valerionew/unisolder-notes/BOMs/Unisolder BOM Digikey.xlsx

REF. | Component | Digikey PN | BOM QTY | Digikey Price Per Unit | Total Price
D18, D19 | MMBD1505A | ‎MMBD1505ACT-ND‎ (https://www.digikey.com/product-detail/en/MMBD1505A/MMBD1505ACT-ND/965669/?itemSeq=286846302) | 2 | 0.34 | $0.68
Rs1 | VISHAY WSL36373L000FEA 0.003 ohm shunt | ‎WSLI-.003CT-ND‎ (https://www.digikey.com/product-detail/en/WSL36373L000FEA/WSLI-.003CT-ND/713514/?itemSeq=286846315) | 1 | 1.7 | $1.70
SPK1 | PB1221P | AI-1441-TWT-12V-R | 1 | 2.36 | $2.36
U6 | REF3030 | 296-26323-1-ND (https://www.digikey.com/product-detail/en/texas-instruments/REF3030AIDBZR/296-26323-1-ND/2254966) | 1 | 1.48 | $1.48
U16 | ADG734 | ADG734BRUZ-ND | 1 | 4.01 | $4.01
U15 | MCP4561T-104E/MS | MCP4561T-104E/MSCT-ND | 1 | 0.99 | $0.99
U10 | MCP4651-104E/ST | MCP4651-104E/ST-ND | 1 | 0.96 | $0.96
 | JBC T245 |  | 1 | 0 | $0.00
 | Tip JBC C245-906 |  | 1 | 0 | $0.00
 | Toroidal transformer 24V 120VA |  | 1 | 0 | $0.00
IronConn | Iron Connector | RPC1-12RB-6P(71) | 1 | 2.98 | $2.98
C1, C3, C5, C7, C9, C10, C17, C18, C59, C60, C62, C65 | SAMSUNG CL21B103KCANNNC 10nF 100V | ‎1276-1249-1-ND‎ (https://www.digikey.com/product-detail/en/CL21B103KCANNNC/1276-1249-1-ND/3889335/?itemSeq=286846531) | 12 | 0.052 | $0.62
C2, C6, C12, C16, C20, C21, C67, C70, C73, C74, C77 | SAMSUNG CL21B104KCFSFNG 100n 100V | 1276-6733-1-ND | 11 | 0.129 | $1.42
C4 | NICHICON UPW1C471MPD 470uF 16V | 493-11717-1-ND | 1 | 0.47 | $0.47
C8, C11 | NICHICON UVZ1H221MPD 220uF 50V | 493-13467-1-ND | 2 | 0.48 | $0.96
C13 | NICHICON UVZ1H220MDD 22uF 50V | 493-1338-ND | 1 | 0.24 | $0.24
C14, C15, C19 | SAMSUNG CL31A106KAHNNNE 10u 25V | 1276-1075-1-ND | 3 | 0.185 | $0.55
C22 | NICHICON UVZ2A470MPD 47uF 100V | 493-13508-1-ND | 1 | 0.47 | $0.47
C23, C47 | VISHAY 293D227X9010D2TE3 220uf 10V | 718-1072-1-ND | 2 | 1.11 | $2.22
C24, C25, C26, C27, C28, C29, C30, C31, C32, C33, C34, C35, C38, C39, C41, C42, C43, C44, C45, C46, C48, C49, C50, C51, C52, C53, C54, C58 | SAMSUNG CL10B104JB8NNNC 100n | 1276-1033-1-ND | 28 | 0.053 | $1.48
C36, C37, C40, C57, C68, C69, C75 | SAMSUNG CL21A106KOQNNNF 10u 16V | 1276-6455-1-ND | 7 | 0.118 | $0.83
C55, C56 | KEMET C0603C150J5GACTU 15p | 720-1618-1-ND | 2 | 0.088 | $0.18
C61, C63, C64, C66 | SAMSUNG CL21B102KBANNNC 1n | 1276-2425-1-ND | 4 | 0.042 | $0.17
C71 | MURATA GRM21BR61E106KA73L 10u 25V | 1276-2890-1-ND | 1 | 0.28 | $0.28
C76 | SAMSUNG CL21C101JBANNNC 100p | 732-7852-1-ND | 1 | 0.1 | $0.10
D16, D20, D21 | BAV199 | BAV199Q-7-FDICT-ND | 3 | 0.24 | $0.72
 | MOLEX 039013022 555702R1 | WM1021-ND | 10 | 0.32 | $3.20
FUSE1 | Keystone 3518P fuse holder | 36-3518P-ND | 2 | 0.27 | $0.54
 | MOLEX 39-00-0039 | WM2501-ND | 20 | 0.17 | $3.40
 | MOLEX 039013022 555702R1 | WM1021-ND | 10 | 0.303 | $3.03
 | MOLEX 039288020 5566-02A-210 | WM23800-ND | 2 | 0.67 | $1.34
 | MOLEX 039288040 5566-04A-210 | WM23801-ND | 3 | 1.05 | $3.15
 | 3M 89110-0101HA | 3M155961-ND | 5 | 1.02 | $5.10
 | 3M N2510-6002RB | MHC10K-ND | 5 | 1.84 | $9.20
HOLDER | RJ11 6 pin HOLDER | WM6356-ND | 1 | 1.13 | $1.13
 | MOLEX 022013037 2695-03RP | WM2001-ND | 10 | 0.19 | $1.90
 | MOLEX 008550102 2759-(555)L | WM2312-ND | 10 | 0.266 | $2.66
 | MOLEX 022292031 AE-6410-03A(241) | WM2745-ND | 2 | 0.67 | $1.34
 | CONN RECEPT 4POS DUAL | WM3701-ND | 3 | 0.31
Ja, Jb, Jc, Jd, Je, Jg | Vishay 0402 0ohm | 541-0.0JCT-ND | 10 | 0.034 | $0.34
L1 | FERROCORE DE1209-330 330uH | 732-4026-1-ND | 1 | 2.12 | $2.12
L2 | FERROCORE DE0704-330 330uH | 732-4046-1-ND | 1 | 2.25 | $2.25
L3 | FERROCORE DJNR4018-100-S 10uH | 732-10757-1-ND | 1 | 0.6 | $0.60
OLED (get a cheaper one please, i had to get this for invoicing reasons) | DD-12864WE-4A | 938 | 1 | 19.95 | $19.95
 | Header 5 | S6103-ND | 1 | 0.47 | $0.47
Q3, Q9 | MMBT5401 | MMBT5401LT1GOSCT-ND | 2 | 0.22 | $0.44
Q4, Q5, Q12 | MMBT5551 | MMBT5551LT1GOSCT-ND | 3 | 0.21 | $0.63
Q6, Q13 | BC847C | 1727-2924-1-ND | 2 | 0.14 | $0.28
Q7 | BCX56-16 | 1727-2930-1-ND | 1 | 0.39 | $0.39
Q14, Q15, Q16, Q18, Q19, Q21, Q22 | IRLML6401 | SI2315BDS-T1-E3CT-ND | 7 | 0.427 | $2.99
R1 | 10k | 541-3983-1-ND | 2 | 0.1 | $0.20
R2, R7, R15, R19, R21, R22 | 4.7k | 541-4207-1-ND | 6 | 0.056 | $0.34
R3 | 0 | SOLDER | 1 | 0 | $0.00
R4, R30, R35, R37, R42, R52, R54, R55, R56, R57, R59, R62, R65 | 1.5k 0.1% | P1.5KDACT-ND (https://www.digikey.com/product-detail/en/panasonic-electronic-components/ERA-6AEB152V/P1.5KDACT-ND/1465951) | 13 | 0.302 | $3.93
R5, R11, R12, R13, R16, R17, R36, R40, R41, R45, R46, R58, R68, R69 | 3k | 311-3.0KARCT-ND | 14 | 0.037 | $0.52
R68 | 3k | A126368CT-ND | 1 | 0.052 | $0.05
 | 4.7k | 311-4.70KCRCT-ND | 1 | 0.052 | $0.05
R6, R9, R14 | 150 | RHM150BUCT-ND | 3 | 0.15 | $0.45
R8, R18 | 30k | RMCF0805JT30K0CT-ND | 2 | 0.1 | $0.20
R10 | 10k | USE R1 | 1 | 0 | $0.00
R20, R32 | 330 | 541-4168-1-ND | 2 | 0.1 | $0.20
R23, R27, R28, R33, R44 | 1.8k | 541-1.8KACT-ND (https://www.digikey.com/product-detail/en/vishay-dale/CRCW08051K80JNEA/541-1.8KACT-ND/1180346) | 5 | 0.044 | $0.22
R24, R34, R51, R60 | 1k 0.1% | 541-3977-1-ND | 4 | 0.06 | $0.24
R25, R26 | 27 | 541-27ACT-ND (https://www.digikey.com/product-detail/en/vishay-dale/CRCW080527R0JNEA/541-27ACT-ND/1180302) | 2 | 0.1 | $0.20
R29, Ra, Rb, Rc, Rd, Re, Rf, Rg | 47 | RMCF0805JT47R0CT-ND | 6 | 0.02 | $0.12
R31, R39 | 100 0.1% | RNCF0805BTE100RCT-ND | 2 | 0.42 | $0.84
R38, R48 | 47k 0.1% | P47KDACT-ND | 2 | 0.36 | $0.72
R43, R61, R64 | 15k | RMCF0805JT15K0CT-ND | 3 | 0.02 | $0.06
R47, R49, R50, R66 | 27k 0.1% | P27KDACT-ND | 5 | 0.32 | $1.60
R53, R63 | 10k 0.1% | P10KDACT-ND | 2 | 0.36 | $0.72
R67 | 820k | RMCF0805JT820KCT-ND | 1 | 0.02 | $0.02
Rc2 | 2k 3364X | 490-2649-1-ND | 1 | 1.57 | $1.57
Rgnd1 | 10M 10000k 2512 | 541-10MXCT-ND | 1 | 0.39 | $0.39
S1, S2, S3 | 4.5 x 6.5 SWITCH-TACTILE SCHURTER 1301.9303 | 486-1943-ND | 3 | 0.23 | $0.69
TVS1 | 1.5KE56A | 1.5KE56A-E3/54GICT-ND | 1 | 0.66 | $0.66
U1 | LM2675M-3.3 | LM2675M-3.3/NOPB-ND‎ | 1 | 5.09 | $5.09
U2 | TC4428ACOA | TC4428ACOA-ND | 1 | 1.17 | $1.17
U3 | SN74HC02D | 296-1188-1-ND | 1 | 0.478 | $0.48
U4 | TC1047AVNBTR | TC1047AVNBCT-ND | 1 | 0.64 | $0.64
U5 | PIC32MX564F128H-I/PT | PIC32MX564F128H-I/PT-ND | 1 | 4.73 | $4.73
U7 | ADuM3160 | ADUM3160BRWZ-RLCT-ND | 1 | 7.77 | $7.77
U8 | 24LC64-I/SN | 24LC64-I/SN-ND | 1 | 0.39 | $0.39
U11 | MCP4716A0T-E/CH | MCP4716A0T-E/CHCT-ND | 1 | 0.84 | $0.84
U12, U13, U18 | MCP6V27-E/SN | MCP6V27-E/SN-ND | 3 | 2.41 | $7.23
USB1 | USB 5 pin | WM2072-ND‎ (https://www.digikey.com/product-detail/en/5000751517/WM2072-ND/1643336/?itemSeq=286905705) | 1 | 4.55 | $4.55
Y1 | 8Mhz HC49US quartz | 300-6017-ND | 1 | 0.59 | $0.59
ZD1, ZD2, ZD4 | BZX384-B3V0.115 3V zener diode | 1727-3653-1-ND | 3 | 0.33 | $0.99
ZD3 | 36V zener diode | MMSZ5258B-FDICT-ND | 1 | 0.24 | $0.24
FUSE1 | ZKS-5A fuse | 283-2686-ND | 1 | 0.34 | $0.34
ZD5, ZD6, ZD7 | 15V zener diode | 1727-3640-1-ND | 3 | 0.33 | $0.99
U1 (alternative to line 80) | LM2675M-ADJ |  | 0 | 0 | $0.00
U19 (see unisolder-notes) | FAN5331 | FAN5331SXCT-ND | 1 | 0.99 | $0.99
U14 | LM4041AIM3-1.2 | LM4041AIM3-1.2/NOPBCT-ND | 1 | 1.93 | $1.93
Q2, Q8 | AOD409 | 785-1103-1-ND | 3 | 0.97 | $2.91
Q1 | NZT605 | NZT605CT-ND | 1 | 0.43 | $0.43
Q10, Q11 | IPD053N08 | ‎IPD053N08N3GATMA1CT-ND‎ | 2 | 2.5 | $2.50
D6, D7, D12 | SK310SMA | SK310A-TPCT-ND | 3 | 0.58 | $1.74
D22 | SK34SMA | SS34FACT-ND | 1 | 0.45 | $0.45
D9, D11, D13 | GF1M | GF1MFSCT-ND | 3 | 0.49 | $1.47
D5, D8, D10, D14, D15 | BAT46W | ‎1727-4816-1-ND‎ (https://www.digikey.com/product-detail/en/BAT46WH%2C115/1727-4816-1-ND/2531303/?itemSeq=286916334) | 5 | 0.35 | $1.75
D1, D2, D3, D4 | SB5100 | SB5100FSCT-ND | 4 | 0.83 | $3.32
U6 (possible alternative to | RED3030 | 296-26323-1-ND | 1 | 1.43 | $1.43
U17 | MCP6V03-E/SN | MCP6V03-E/SN-ND | 1 | 1.79 | $1.79
 | 150 0.1% | 150ADCT-ND | 1 | 0.66 | $0.66
 | 5.6k 0.1% | 5.6KADCT-ND | 1 | 0.66 | $0.66
 | 10 0.1% | A105944CT-ND | 1 | 0.62 | $0.62
 | TOTAL
 |  |  |  |  | $164.99
