valerionew/unisolder-notes/BOMs/UniSolder52_BOM_original_25Mar2019_Download.xls

Designator | Comment | Supplier | Quantity | Package | Description
C1, C3, C5, C7, C9, C10, C17, C18, C59, C60, C62, C65 | 10n 100V | Comet | 12 | 0805 | Capacitor
C2, C6, C12, C16, C20, C21, C67, C70, C73, C74, C77 | 100n 100V | Comet | 11 | 0805 | Capacitor, Capacitor, Capacitor, Capacitor, Capacitor, Capacitor, Capacitor (Semiconductor SIM Model), Capacitor, Capacitor, Capacitor, Capacitor
C4 | 470uF 16V | Comet | 1 | TH10x12.5 | Polarized Capacitor (Radial)
C8, C11 | 220uF 50V | Comet | 2 | TH10x12.5 | Polarized Capacitor (Radial)
C13 | 22uF 50V | Comet | 1 | TH5x11 | Polarized Capacitor (Radial)
C14, C15, C19 | 10u 25V | Comet | 3 | 1206 | Capacitor
C22 | 47uF 100V | Comet | 1 | TH10x12.5 | Polarized Capacitor (Radial)
C23, C47 | 220uf 10V | Comet | 2 | D | Tantalum SMD Capacitor
C24, C25, C26, C27, C28, C29, C30, C31, C32, C33, C34, C35, C38, C39, C41, C42, C43, C44, C45, C46, C48, C49, C50, C51, C52, C53, C54, C58 | 100n | Comet | 28 | 0603 | Capacitor
C36, C37, C40, C57, C68, C69, C75 | 10u 16V | Comet | 7 | 0805 | Capacitor
C55, C56 | 15p | Comet | 2 | 0603 | Capacitor
C61, C63, C64, C66 | 1n | Comet | 4 | 0805 | Capacitor
C71 | 10u 25V | Comet | 1 | 0805 | Capacitor
C76 | 100p | Comet | 1 | 0805 | Capacitor
D1, D2, D3, D4 | SR580 | Comet | 4 | DO-201AD | Schottky Diode
D5, D8, D10, D14, D15 | BAT46WH | Comet | 5 | SOD123 | Schottky Rectifier
D6, D7, D12 | SS310A | Comet | 3 | SMA | Schottky Rectifier
D9, D11, D13 | 1N4007 | Comet | 3 | SMA | 1 Amp General Purpose Rectifier
D16, D17, D20, D21 | BAV199 | Farnell | 4 | SOT23
D18, D19 | MMBD1505A | Farnell | 2 | SOT23
D22 | SS34A | Comet | 1 | SMA | Schottky Rectifier
DS1, DS2, DS3 | SA36-11SRWA | Comet | 3 | DIP10 | 7.62 mm Black Surface HER 7-Segment Display: CA, RH DP
FUSE1 | 5A | Comet | 1 | 2x3518P | 2x Keystone 3518P fuse holder
J1 | 24VAC | Comet | 1 | 1x2x4.2 | Header, 2-Pin
J2 | IRON | Comet | 1 | 2x2x4.2 | Header, 4-Pin
J3, J9 | PWR | Comet | 2 | 2x2x4.2 | Header, 4-Pin
J4, J8 | CNTR | Comet | 2 | 2x5x2.54 | Header, 10-Pin
J5 | HOLDER | Comet | 1 | RJ11V | Header, 8-Pin
J6 | SENSOR | Comet | 1 | CI31-3 | Header, 3-Pin
J7 | 24VDC | Comet | 1 | 1x2x4.2 | Header, 2-Pin
Ja, Jb, Jc, Jd, Je, Jg | 0 | Comet | 6 | 0403 | Resistor
L1 | 330uH | Comet | 1 | DRH125 | Inductor
L2 | 330uH | Comet | 1 | DRH74 | Inductor
L3 | 10uH | Farnell | 1 | LPS4018 | Inductor
OLED1 | UG-2864HSWEG01 | Texim | 1 |  | 0.96' 128x64 OLED Display
P1, P2, PD1 | Header 5 | Comet | 3 | 1x5x2.54 | Header, 5-Pin
Q1 | FZT605 | Comet | 1 | SOT89 | SOT223 NPN Silicon Planar Medium Power Darlington Transistor
Q2, Q8 | SUD50P10 | Farnell | 2 | TO252 | HEXFET Power MOSFET
Q3, Q9 | MMBT5401 | Comet | 2 | SOT23 | PNP General-purpose Transistor
Q4, Q5, Q12 | MMBT5551 | Comet | 3 | SOT23 | NPN General-purpose Transistor
Q6, Q13 | BC847C | Comet | 2 | SOT23 | NPN General-purpose Transistor
Q7 | BCX56-16 | Comet | 1 | SOT89 | NPN High-voltage Transistor
Q10, Q11 | IPD053N08 | Farnell | 2 | TO252 | HEXFET N-Channel Power MOSFET
Q14, Q15, Q16, Q18, Q19, Q21, Q22 | IRLML6401 | Comet | 7 | SOT23 | HEXFET Power MOSFET
Q17, Q20 | IRLML2502 | Comet | 2 | SOT23 | HEXFET Power MOSFET
R1 | 10k | Comet | 1 | 1206 | Resistor
R2, R7, R15, R19, R21, R22 | 4.7k | Comet | 7 | 0805 | Resistor
R3 | 0 | Comet | 7 | 0805 | Resistor/Solder jumper
R4, R30, R35, R37, R42, R52, R54, R55, R56, R57, R59, R62, R65 | 1.5k 0.1% | Farnell, Farnell, Farnell, Farnell, Farnell, Farnell, Farnell, Comet, Farnell, Farnell, Farnell, Farnell, Farnell | 13 | 0805 | Resistor
R5, R11, R12, R13, R16, R17, R36, R40, R41, R45, R46, R58, R68, R69 | 3k | Comet | 14 | 0805 | Resistor
R6, R9, R14 | 150 | Comet | 3 | 0805 | Resistor
R8, R18 | 30k | Comet | 2 | 0805 | Resistor
R10 | 10k | Farnell | 1 | 0805 | Resistor
R20, R32 | 330 | Comet | 2 | 0805 | Resistor
R23, R27, R28, R33, R44 | 1.8k | Comet | 5 | 0805 | Resistor
R24, R34, R51, R60 | 1k 0.1% | Farnell | 4 | 0805 | Resistor
R25, R26 | 27 | Comet | 2 | 0805 | Resistor
R29, Ra, Rb, Rc, Rd, Re, Rf, Rg | 47 | Comet | 8 | 0805 | Resistor
R31, R39 | 100 0.1% | Farnell | 2 | 0805 | Resistor
R38, R48 | 47k 0.1% | Farnell | 2 | 0805 | Resistor
R43, R61, R64 | 15k | Comet | 3 | 0805 | Resistor
R47, R49, R50, R66 | 27k 0.1% | Farnell | 4 | 0805 | Resistor
R53, R63 | 10k 0.1% | Farnell | 2 | 0805 | Resistor
R67 | 820k | Comet | 1 | 0805 | Resistor
Rc2 | 2k | Farnell | 1 | Bourns 3362 | Potentiometer
Rgnd1 | 10000k | Comet | 1 | 2512 | Resistor
Rs1 | 0.003 | Comet | 1 | WSL3637 | 4lead shunt resistor
S1, S2, S3 | SWITCH-TACTILE | Comet | 3
SPK1 | PB1221P | Comet | 1 | SPK12x9x6.5 | Speaker 12mm
TVS1 | 60V | Farnell | 1 | DO-201AD | Tranzorb
U1 | LM2675M-3.3 | Comet | 1 | SOIC8 | SIMPLE SWITCHER® Power Converter High Efficiency 1A Step-Down Voltage Regulator, 8-pin Narrow SOIC
U2 | TC4428ACOA | Comet | 1 | SOIC8 | 1.5A Dual High-Speed Power MOSFET Driver, Complementary, Commercial Temperature
U3 | SN74HC02D | Comet | 1 | SOIC14 | Quadruple 2-Input Positive-NOR Gate
U4 | TC1047AVNBTR | Comet | 1 | SOT23 | Precision Temperature-to-Voltage Converter, 3-Pin SOT-23, Extended Temperature, Tape and Reel
U5 | PIC32MX564F128H-I/PT | Farnell | 1 | TQFP64 | High Performance 80 MHz MIPS-Based 32-Bit Flash Microcontroller with USB and CAN, 128KB Program Memory, 64-pin TQFP, Industrial Temperature
U6 | REF3030 | Farnell | 1 | SOT23
U7 | ADuM3160 | Farnell | 1 | SOIC16W | USB Isolator
U8 | 24LC64-I/SN | Comet | 1 | SOIC8 | 64Kbit, 400kHz, 2.5V, I2C Serial EEPROM, 8-Pin SOIC 150mil, Industrial Temperature
U9 | ULN2003L | Comet | 1 | SOIC16 | High-Voltage, High-Current Darlington Array
U10 | MCP4651-503E/ST | Farnell | 1 | TSSOP14 | 8-Bit Dual I2C Digital POT with Volatile Memory, 14-pin TSSOP, Extended Temperature
U11 | MCP4716A0T-E/CH | Farnell | 1 | SOT23-6 | 10-Bit Voltage Output Digital-to-Analog Converter with EEPROM and I2C Interface, 6-Pin SOT-23, Extended Temperature, Tape and Reel
U12, U13, U18 | MCP6V27-E/SN | Farnell | 3 | SOIC8 | 110 µA, High Precision Dual Op Amp, 8-Pin SOIC, Extended Temperature, 620 µA, 2 MHz Auto-Zeroed Dual Op Amp, 8-Pin SOIC, Extended Temperature, 620 µA, 2 MHz Auto-Zeroed Dual Op Amp, 8-Pin SOIC, Extended Temperature
U14 | LM4041CIM3-1.2 | Farnell | 1 | SOT23 | Precision Micropower Shunt Voltage Reference, 3-pin SOT-23
U15 | MCP4561T-503E/MS | Farnell | 1 | MSOP8 | 8-Bit Single I2C Digital POT with Non-Volatile Memory, 8-pin MSOP, Extended Temperature, Tape and Reel
U16 | ADG734 | Farnell | 1 | TSSOP20 | AD 4 SPDT
U17 | MCP6V28-E/SN | Farnell | 1 | SOIC8 | 620 µA, 2 MHz Auto-Zeroed Op Amp with CS pin, 8-Pin SOIC, Extended Temperature
U19 | FAN5331 | Comet | 1 | SOT23-5 | LED boost driver
USB1 | USB 5 pin | Comet | 1 | MINIUSB-V
Y1 | 8Mhz | Comet | 1 | HC49US | Crystal Oscillator
ZD1, ZD2 | 3V | Comet | 2 | SOD123 | Zener Diode
ZD3 | 36V | Comet | 1 | SOD123 | Zener Diode
ZD4 | 3.0V | Comet | 1 | SOD123 | Zener Diode
ZD5, ZD6, ZD7 | 15V | Comet | 3 | SOD123 | Zener Diode
