valerionew/unisolder-notes/BOMs/Unisolder BOM TME Farnell.xlsx

Please note that this bom is made by stitching several orders i've made. Several things, such as the connectors, may be missing. Please check for yourself the BOM before buying. Notes and alternative parts are available at https://github.com/5N44P/unisolder-notes.
REF. | Component | Unit price | Min pcs sold or needed | Total w/o VAT | Total with VAT | Supplier | Project and notes | Link
D18, D19 | MMBD1505A | 0.051300 € | 10 | 0.51 € | 0.63 € | tme.eu | Unisolder | https://www.tme.eu/it/details/mmbd1505a/diodi-universali-smd/on-semiconductor/
Rs1 | VISHAY WSL36373L000FEA 0.003 ohm shunt | 1.040000 € | 10 | 10.40 € | 12.69 € | farnell.com | Unisolder | http://it.farnell.com/vishay/wsl36373l000fea/resistor-smd-0-0-003-ohm-2-w/dp/1107417
SPK1 | PB1221P | 0.356000 € | 1 | 0.36 € | 0.43 € | farnell.com | Unisolder | http://it.farnell.com/multicomp/mckp12-g185b-3709/trasduttore-thru-hole-1v-10ma/dp/2135915?ost=PB1221P
U6 | REF3030 | 1.960000 € | 2 | 3.92 € | 4.78 € | farnell.com | Unisolder | http://it.farnell.com/texas-instruments/ref3030aidbzt/rif-tensione-serie-3v-sot-23-3/dp/1755077
U16 | ADG734 | 3.870000 € | 1 | 3.87 € | 4.72 € | farnell.com | Unisolder | http://it.farnell.com/analog-devices/adg734bruz/analogue-switch-quad-spdt-20tssop/dp/1661037
U15 | MCP4561T-104E/MS | 1.270000 € | 1 | 1.27 € | 1.55 € | farnell.com | Unisolder (instead of MCP4561-503E) | http://it.farnell.com/microchip/mcp4561-104e-ms/ic-dgtl-pot-100k-256taps-8-msop/dp/1840687
U10 | MCP4651-104E/ST | 0.956000 € | 1 | 0.96 € | 1.17 € | farnell.com | Unisolder (instead of MCP4651-503E) | http://it.farnell.com/microchip/mcp4651-104e-st/dgtl-pot-100k-256taps-14tssop/dp/1840684
 | JBC T245 | 58.000000 € | 1 | 58.00 € | 70.76 € | tme.eu | Unisolder | http://www.tme.eu/it/details/jbc-t245-b/stazioni-saldanti-pezzi-di-ricambio/jbc-tools/t245-b/
 | Tip JBC C245-906 | 23.200000 € | 1 | 23.20 € | 28.30 € | tme.eu | Unisolder | http://www.tme.eu/it/details/jbc-c245906/punte-saldanti/jbc-tools/c245-906/
 | Toroidal transformer 24V 120VA | 18.190000 € | 1 | 18.19 € | 22.19 € | tme.eu | Unisolder | http://www.tme.eu/it/details/tst120w_24v/trasformatori-toroidali/indel/tst120003/
C1, C3, C5, C7, C9, C10, C17, C18, C59, C60, C62, C65 | SAMSUNG CL21B103KCANNNC 10nF 100V | 0.005970 € | 100 | 0.60 € | 0.73 € | tme.eu | Unisolder | http://www.tme.eu/it/details/cl21b103kcannnc/condensatori-mlcc-smd-0805/samsung/
C2, C6, C12, C16, C20, C21, C67, C70, C73, C74, C77 | SAMSUNG CL21B104KCFSFNG 100n 100V | 0.011220 € | 100 | 1.12 € | 1.37 € | tme.eu | Unisolder | http://www.tme.eu/it/details/cl21b104kcfsfng/condensatori-mlcc-smd-0805/samsung/
C4 | NICHICON UPW1C471MPD 470uF 16V | 0.145000 € | 10 | 1.45 € | 1.77 € | tme.eu | Unisolder | http://www.tme.eu/it/details/upw1c471mpd/condensatori-elettrol-tht-bassa-imped/nichicon/
C8, C11 | NICHICON UVZ1H221MPD 220uF 50V | 0.141220 € | 5 | 0.71 € | 0.86 € | tme.eu | Unisolder | http://www.tme.eu/it/details/uvz1h221mpd/condensatori-elettrolitici-tht-105c/nichicon/
C13 | NICHICON UVZ1H220MDD 22uF 50V | 0.048640 € | 25 | 1.22 € | 1.48 € | tme.eu | Unisolder | http://www.tme.eu/it/details/uvz1h220mdd/condensatori-elettrolitici-tht-105c/nichicon/
C14, C15, C19 | SAMSUNG CL31A106KAHNNNE 10u 25V | 0.024800 € | 100 | 2.48 € | 3.03 € | tme.eu | Unisolder | http://www.tme.eu/it/details/cl31a106kahnnne/condensatori-mlcc-smd-1206/samsung/
C22 | NICHICON UVZ2A470MPD 47uF 100V | 0.128750 € | 5 | 0.64 € | 0.79 € | tme.eu | Unisolder | http://www.tme.eu/it/details/uvz2a470mpd/condensatori-elettrolitici-tht-105c/nichicon/
C23, C47 | VISHAY 293D227X9010D2TE3 220uf 10V | 0.532760 € | 2 | 1.07 € | 1.30 € | tme.eu | Unisolder | http://www.tme.eu/it/details/293d227x9010d2te3/condesatori-di-tantalio-smd/vishay/
C24, C25, C26, C27, C28, C29, C30, C31, C32, C33, C34, C35, C38, C39, C41, C42, C43, C44, C45, C46, C48, C49, C50, C51, C52, C53, C54, C58 | SAMSUNG CL10B104JB8NNNC 100n | 0.005530 € | 100 | 0.55 € | 0.67 € | tme.eu | Unisolder | http://www.tme.eu/it/details/cl10b104jb8nnnc/condensatori-mlcc-smd-0603/samsung/
C36, C37, C40, C57, C68, C69, C75 | SAMSUNG CL21A106KOQNNNF 10u 16V | 0.019500 € | 100 | 1.95 € | 2.38 € | tme.eu | Unisolder | http://www.tme.eu/it/details/cl21a106koqnnnf/condensatori-mlcc-smd-0805/samsung/
C55, C56 | KEMET C0603C150J5GACTU 15p | 0.047500 € | 100 | 4.75 € | 5.79 € | tme.eu | Unisolder | http://www.tme.eu/it/details/c0603c150j5gac/condensatori-mlcc-smd-0603/kemet/c0603c150j5gactu/
C61, C63, C64, C66 | SAMSUNG CL21B102KBANNNC 1n | 0.006780 € | 100 | 0.68 € | 0.83 € | tme.eu | Unisolder | http://www.tme.eu/it/details/cl21b102kbannnc/condensatori-mlcc-smd-0805/samsung/
C71 | MURATA GRM21BR61E106KA73L 10u 25V | 0.124000 € | 10 | 1.24 € | 1.51 € | tme.eu | Unisolder | http://www.tme.eu/it/details/grm21br61e106ka73l/condensatori-mlcc-smd-0805/murata/
C76 | SAMSUNG CL21C101JBANNNC 100p | 0.008530 € | 100 | 0.85 € | 1.04 € | tme.eu | Unisolder | http://www.tme.eu/it/details/cl21c101jbannnc/condensatori-mlcc-smd-0805/samsung/
D16, D20, D21 | BAV199 | 0.025200 € | 25 | 0.63 € | 0.77 € | tme.eu | Unisolder | http://www.tme.eu/it/details/bav199.215/diodi-universali-smd/nexperia/
 | MOLEX 039013022 555702R1 | 0.241000 € | 10 | 2.41 € | 2.94 € | tme.eu | Unisolder | http://www.tme.eu/it/details/mx-39-01-3022/connettori-di-segnale-passo-420mm/molex/039013022-555702r1/
FUSE1 | Keystone 3518P fuse holder | 0.171900 € | 5 | 0.86 € | 1.05 € | tme.eu | Unisolder | http://www.tme.eu/it/details/keys3518p/fusibili-porta-fusibili-pcb/keystone/3518p/
 | MOLEX 39-00-0039 | 0.057510 € | 20 | 1.15 € | 1.40 € | tme.eu | Unisolder | http://www.tme.eu/it/details/mx-5556tl/connettori-di-segnale-passo-420mm/molex/39-00-0039/
 | MOLEX 039013022 555702R1 | 0.241000 € | 10 | 2.41 € | 2.94 € | tme.eu | Unisolder | http://www.tme.eu/it/details/mx-39-01-3022/connettori-di-segnale-passo-420mm/molex/039013022-555702r1/
 | MOLEX 039288020 5566-02A-210 | 0.223000 € | 2 | 0.45 € | 0.54 € | tme.eu | Unisolder | http://www.tme.eu/it/details/mx-39-28-8020/connettori-di-segnale-passo-420mm/molex/039288020-5566-02a-210/
 | MOLEX 039288040 5566-04A-210 | 0.307000 € | 3 | 0.92 € | 1.12 € | tme.eu | Unisolder | http://www.tme.eu/it/details/mx-39-28-8040/connettori-di-segnale-passo-420mm/molex/039288040-5566-04a-210/
 | 3M 89110-0101HA | 0.940000 € | 5 | 4.70 € | 5.73 € | tme.eu | Unisolder | http://www.tme.eu/it/details/89110-0101ha/connettori-idc/3m/
 | 3M N2510-6002RB | 0.932860 € | 5 | 4.66 € | 5.69 € | tme.eu | Unisolder | http://www.tme.eu/it/details/n2510-6002rb/connettori-idc/3m/
HOLDER | RJ11 6 pin HOLDER | 0.530000 € | 1 | 0.53 € | 0.65 € | tme.eu | Unisolder | http://www.tme.eu/it/details/mx-95522-2667/connettori-rj/molex/955222667/
 | MOLEX 022013037 2695-03RP | 0.684000 € | 10 | 6.84 € | 8.34 € | tme.eu | Unisolder | http://www.tme.eu/it/details/mx-22-01-3037/connettori-di-segnale-passo-254mm/molex/022013037-2695-03rp/
 | MOLEX 008550102 2759-(555)L | 0.049900 € | 10 | 0.50 € | 0.61 € | tme.eu | Unisolder | http://www.tme.eu/it/details/mx-08-55-0102/connettori-di-segnale-passo-254mm/molex/008550102-2759-555l/
 | MOLEX 022292031 AE-6410-03A(241) | 0.240000 € | 2 | 0.48 € | 0.59 € | tme.eu | Unisolder | http://www.tme.eu/it/details/mx-22-29-2031/connettori-di-segnale-passo-254mm/molex/022292031-ae-6410-03a241/
Ja, Jb, Jc, Jd, Je, Jg | Vishay 0402 0ohm | 0.004340 € | 100 | 0.43 € | 0.53 € | tme.eu | Unisolder | http://www.tme.eu/it/details/crcw04020000z0tdbc/resistori-smd-0402/vishay/
L1 | FERROCORE DE1209-330 330uH | 0.328320 € | 5 | 1.64 € | 2.00 € | tme.eu | Unisolder | http://www.tme.eu/it/details/de1209-330/induttori-di-potenza-smd/ferrocore/
L2 | FERROCORE DE0704-330 330uH | 0.266200 € | 5 | 1.33 € | 1.62 € | tme.eu | Unisolder | http://www.tme.eu/it/details/de0704-330/induttori-di-potenza-smd/ferrocore/
L3 | FERROCORE DJNR4018-100-S 10uH | 0.130800 € | 5 | 0.65 € | 0.80 € | tme.eu | Unisolder | http://www.tme.eu/it/details/djnr4018-100-s/induttori-di-potenza-smd/ferrocore/
OLED (get a cheaper one please, i had to get this for invoicing reasons) | DD-12864WE-4A | 21.120000 € | 1 | 21.12 € | 25.77 € | farnell.com | Unisolder | https://it.farnell.com/densitron/dd-12864we-4a/pmoled-128-64-bianco/dp/1829709
 | Header 5 | 0.068000 € | 10 | 0.68 € | 0.83 € | tme.eu | Unisolder | http://www.tme.eu/it/details/zl262-5sg/prese-e-spine-tipo-c-gird/ninigi/
Q3, Q9 | MMBT5401 | 0.020500 € | 25 | 0.51 € | 0.63 € | tme.eu | Unisolder | http://www.tme.eu/it/details/mmbt5401/transistori-pnp-smd/on-semiconductor/mmbt5401lt1g/
Q4, Q5, Q12 | MMBT5551 | 0.019100 € | 25 | 0.48 € | 0.58 € | tme.eu | Unisolder | http://www.tme.eu/it/details/mmbt5551/transistori-npn-smd/on-semiconductor/mmbt5551lt1g/
Q6, Q13 | BC847C | 0.018600 € | 25 | 0.46 € | 0.57 € | tme.eu | Unisolder | http://www.tme.eu/it/details/bc847c.215/transistori-npn-smd/nexperia/
Q7 | BCX56-16 | 0.097600 € | 5 | 0.49 € | 0.60 € | tme.eu | Unisolder | http://www.tme.eu/it/details/bcx56-16.115/transistori-npn-smd/nexperia/bcx56-16215/
Q14, Q15, Q16, Q18, Q19, Q21, Q22 | IRLML6401 | 0.080900 € | 10 | 0.81 € | 0.99 € | tme.eu | Unisolder | http://www.tme.eu/it/details/irlml6401trpbf/transistori-con-canale-p-smd/infineon-irf/
R1 | 10k | 0.007050 € | 100 | 0.70 € | 0.86 € | tme.eu | Unisolder | http://www.tme.eu/it/details/smd1206-10k-1%25/resistori-smd-1206/royal-ohm/1206s4f1002t5e/
R2, R7, R15, R19, R21, R22 | 4.7k | 0.006110 € | 100 | 0.61 € | 0.75 € | tme.eu | Unisolder | http://www.tme.eu/it/details/smd0805-4k7/resistori-smd-0805/royal-ohm/0805s8j0472t5e/
R3 | 0 | 0.005890 € | 100 | 0.59 € | 0.72 € | tme.eu | Unisolder | http://www.tme.eu/it/details/smd0805-0r/resistori-smd-0805/royal-ohm/0805s8j0000t5e/
R4, R30, R35, R37, R42, R52, R54, R55, R56, R57, R59, R62, R65 | 1.5k 0.1% | 0.112890 € | 13 | 1.47 € | 1.79 € | tme.eu | Unisolder | http://www.tme.eu/it/details/tc0525b1501t1e/resistori-di-precisione-smd-0805/royal-ohm/
R5, R11, R12, R13, R16, R17, R36, R40, R41, R45, R46, R58, R68, R69 | 3k | 0.006110 € | 100 | 0.61 € | 0.75 € | tme.eu | Unisolder | http://www.tme.eu/it/details/smd0805-3k/resistori-smd-0805/royal-ohm/0805s8j0302t5e/
R6, R9, R14 | 150 | 0.006110 € | 100 | 0.61 € | 0.75 € | tme.eu | Unisolder | http://www.tme.eu/it/details/smd0805-150r/resistori-smd-0805/royal-ohm/0805s8j0151t5e/
R8, R18 | 30k | 0.006110 € | 100 | 0.61 € | 0.75 € | tme.eu | Unisolder | http://www.tme.eu/it/details/smd0805-30k/resistori-smd-0805/royal-ohm/0805s8j0303t5e/
R10 | 10k | 0.006110 € | 100 | 0.61 € | 0.75 € | tme.eu | Unisolder | http://www.tme.eu/it/details/smd0805-10k/resistori-smd-0805/royal-ohm/0805s8j0103t5e/
R20, R32 | 330 | 0.006110 € | 100 | 0.61 € | 0.75 € | tme.eu | Unisolder | http://www.tme.eu/it/details/smd0805-330r/resistori-smd-0805/royal-ohm/0805s8j0331t5e/
R23, R27, R28, R33, R44 | 1.8k | 0.006110 € | 100 | 0.61 € | 0.75 € | tme.eu | Unisolder | http://www.tme.eu/it/details/smd0805-1k8/resistori-smd-0805/royal-ohm/0805s8j0182t5e/
R24, R34, R51, R60 | 1k 0.1% | 0.112890 € | 10 | 1.13 € | 1.38 € | tme.eu | Unisolder | http://www.tme.eu/it/details/tc0525b1001t1e/resistori-di-precisione-smd-0805/royal-ohm/
R25, R26 | 27 | 0.006110 € | 100 | 0.61 € | 0.75 € | tme.eu | Unisolder | http://www.tme.eu/it/details/smd0805-27r/resistori-smd-0805/royal-ohm/0805s8j0270t5e/
R29, Ra, Rb, Rc, Rd, Re, Rf, Rg | 47 | 0.006110 € | 100 | 0.61 € | 0.75 € | tme.eu | Unisolder | http://www.tme.eu/it/details/smd0805-47r/resistori-smd-0805/royal-ohm/0805s8j0470t5e/
R31, R39 | 100 0.1% | 0.117590 € | 10 | 1.18 € | 1.43 € | tme.eu | Unisolder | http://www.tme.eu/it/details/smd0805-100r-hp25/resistori-di-precisione-smd-0805/royal-ohm/tc0525b0101t5/
R38, R48 | 47k 0.1% | 0.112890 € | 10 | 1.13 € | 1.38 € | tme.eu | Unisolder | http://www.tme.eu/it/details/tc0525b4702t1e/resistori-di-precisione-smd-0805/royal-ohm/
R43, R61, R64 | 15k | 0.006110 € | 100 | 0.61 € | 0.75 € | tme.eu | Unisolder | http://www.tme.eu/it/details/smd0805-15k/resistori-smd-0805/royal-ohm/0805s8j0153t5e/
R47, R49, R50, R66 | 27k 0.1% | 0.111240 € | 10 | 1.11 € | 1.36 € | tme.eu | Unisolder | http://www.tme.eu/it/details/ar0805-27k-0.1%25/resistori-di-precisione-smd-0805/viking/ar05btcw2702/
R53, R63 | 10k 0.1% | 0.112890 € | 10 | 1.13 € | 1.38 € | tme.eu | Unisolder | http://www.tme.eu/it/details/tc0525b1002t1e/resistori-di-precisione-smd-0805/royal-ohm/
R67 | 820k | 0.006110 € | 100 | 0.61 € | 0.75 € | tme.eu | Unisolder | http://www.tme.eu/it/details/smd0805-820k/resistori-smd-0805/royal-ohm/0805s8j0824t5e/
Rc2 | 2k 3364X | 0.460000 € | 5 | 2.30 € | 2.81 € | tme.eu | Unisolder | http://www.tme.eu/it/details/3364x-1-202e/potenziometri-smd-mono-giro/bourns/
Rgnd1 | 10M 10000k 2512 | 0.023520 € | 100 | 2.35 € | 2.87 € | tme.eu | Unisolder | http://www.tme.eu/it/details/smd2512-10m/resistori-smd-2512/royal-ohm/25121wj0106t4e/
S1, S2, S3 | 4.5 x 6.5 SWITCH-TACTILE SCHURTER 1301.9303 | 0.230000 € | 10 | 2.30 € | 2.81 € | tme.eu | Unisolder | http://www.tme.eu/it/details/1301.9303/microinterruttori-tact-pcb/schurter/
TVS1 | 1.5KE56A | 0.220000 € | 3 | 0.66 € | 0.81 € | tme.eu | Unisolder | http://www.tme.eu/it/details/1.5ke56a-e3_54/diodi-transil-tht-unidirezionali/vishay/
U1 (alternative to line 96) | LM2671-3.3 | 4.340000 € | 1 | 4.34 € | 5.29 € | tme.eu | Unisolder | http://www.tme.eu/it/details/lm2671m-3.3/regolatori-di-tensione-circuiti-dc-dc/texas-instruments/lm2671m-33nopb/
U2 | TC4428ACOA | 1.070000 € | 1 | 1.07 € | 1.31 € | tme.eu | Unisolder | http://www.tme.eu/it/details/tc4428acoa/driver-mosfetigbt/microchip-technology/
U3 | SN74HC02D | 0.109100 € | 5 | 0.55 € | 0.67 € | tme.eu | Unisolder | http://www.tme.eu/it/details/sn74hc02dr/gate-invertitori/texas-instruments/
U4 | TC1047AVNBTR | 0.737500 € | 1 | 0.74 € | 0.90 € | tme.eu | Unisolder | http://www.tme.eu/it/details/tc1047avnbtr/trasduttori-di-temperatura/microchip-technology/
U5 | PIC32MX564F128H-I/PT | 5.690000 € | 1 | 5.69 € | 6.94 € | tme.eu | Unisolder | http://www.tme.eu/it/details/pic32mx564f128h/microcontrollori-microchip-32-bit/microchip-technology/pic32mx564f128h-ipt/
U7 | ADuM3160 | 6.300000 € | 1 | 6.30 € | 7.69 € | tme.eu | Unisolder | http://www.tme.eu/it/details/adum3160brwz-rl/circuiti-integrati-interf-rimanenti/analog-devices/
U8 | 24LC64-I/SN | 0.440000 € | 3 | 1.32 € | 1.61 € | tme.eu | Unisolder | http://www.tme.eu/it/details/24lc64-i_sn/memorie-eeprom-seriali/microchip-technology/
U11 | MCP4716A0T-E/CH | 1.260000 € | 1 | 1.26 € | 1.54 € | tme.eu | Unisolder | http://www.tme.eu/it/details/mcp4716a0t-e_ch/trasduttori-da-circuiti-integrati/microchip-technology/
U12, U13, U18 | MCP6V27-E/SN | 3.260000 € | 3 | 9.78 € | 11.93 € | tme.eu | Unisolder | http://www.tme.eu/it/details/mcp6v27-e_sn/amplificatori-operazionali-smd/microchip-technology/
USB1 | USB 5 pin | 1.870000 € | 2 | 3.74 € | 4.56 € | tme.eu | Unisolder | http://www.tme.eu/it/details/mx-500075-1517/connettori-usb-e-ieee-1394/molex/5000751517/
U1 | 8Mhz HC49US quartz | 0.495000 € | 2 | 0.99 € | 1.21 € | tme.eu | Unisolder | http://www.tme.eu/it/details/hc49us-ff5f8.0000/risonatori-al-quarzo-tht/ilsi/hc49us-ff5f18-80000/
ZD1, ZD2, ZD4 | BZX384-B3V0.115 3V zener diode | 0.031200 € | 25 | 0.78 € | 0.95 € | tme.eu | Unisolder | http://www.tme.eu/it/details/bzx384-b3v0.115/diodi-zener-smd/nexperia/
ZD3 | 36V zener diode | 0.031200 € | 25 | 0.78 € | 0.95 € | tme.eu | Unisolder | http://www.tme.eu/it/details/bzx384-b36.115/diodi-zener-smd/nexperia/
FUSE1 | ZKS-5A fuse | 0.104000 € | 10 | 1.04 € | 1.27 € | tme.eu | Unisolder | http://www.tme.eu/it/details/zks-5a/fusibili-5x20mm-veloci/eska/520624/
ZD5, ZD6, ZD7 | 15V zener diode | 0.031200 € | 25 | 0.78 € | 0.95 € | tme.eu | Unisolder | http://www.tme.eu/it/details/bzx384-b15.115/diodi-zener-smd/nexperia/
U1 (alternative to line 80) | LM2675M-ADJ | 3.550000 € | 1 | 3.55 € | 4.33 € | tme.eu | Unisolder (adjystable compatible) | http://www.tme.eu/it/details/lm2675m-adjnopb/regolatori-di-tensione-circuiti-dc-dc/texas-instruments/lm2675m-adjnopb/
U19 (see unisolder-notes) | FAN5333 | 0.620000 € | 1 | 0.62 € | 0.76 € | tme.eu | Unisolder (better performing FAN5331) | http://www.tme.eu/it/details/fan5333bsx/driver-per-led/fairchild-semiconductor/
U14 | LM4041AIM3-1.2 | 1.610000 € | 1 | 1.61 € | 1.96 € | tme.eu | Unisolder (better performing LM4041CIM3-1.2) | http://www.tme.eu/it/details/lm4041aim3-1.2_nop/fonti-di-tens-di-riferimento-circuiti/texas-instruments/lm4041aim3-12nopb/
Q2, Q8 | AOD409 | 0.590000 € | 3 | 1.77 € | 2.16 € | tme.eu | Unisolder (equiv SUD50P10) | http://www.tme.eu/it/details/aod409/transistori-con-canale-p-smd/alpha-omega-semiconductor/
Q1 | NZT605 | 0.117000 € | 5 | 0.59 € | 0.71 € | tme.eu | Unisolder (equiv FZT605) | http://www.tme.eu/it/details/nzt605/transistori-di-darlington-npn-smd/fairchild-semiconductor/
D6, D7, D12 | SK310SMA | 0.087400 € | 10 | 0.87 € | 1.07 € | tme.eu | Unisolder (equiv SS310A) | http://www.tme.eu/it/details/sk310sma-dio/diodi-schottky-smd/diotec-semiconductor/sk310sma/
D22 | SK34SMA | 0.069300 € | 10 | 0.69 € | 0.85 € | tme.eu | Unisolder (equiv SS34A) | http://www.tme.eu/it/details/sk34sma-dio/diodi-schottky-smd/diotec-semiconductor/sk34sma/
D9, D11, D13 | GF1M | 0.105000 € | 5 | 0.53 € | 0.64 € | tme.eu | Unisolder (equiv. 1N4007 sma) | http://www.tme.eu/it/details/gf1m-fai/diodi-universali-smd/fairchild-semiconductor/gf1m/
D5, D8, D10, D14, D15 | BAT46W | 0.022700 € | 25 | 0.57 € | 0.69 € | tme.eu | Unisolder (equiv. BAT46WH) | http://www.tme.eu/it/details/bat46w-dio/diodi-schottky-smd/diotec-semiconductor/bat46w/
D1, D2, D3, D4 | SB5100 | 0.162000 € | 5 | 0.81 € | 0.99 € | tme.eu | Unisolder (equiv. SR580) | http://www.tme.eu/it/details/sb5100-dio/diodi-schottky-tht/diotec-semiconductor/sb5100/
U6 (possible alternative to | LM4120AIM5-3.0 | 1.850000 € | 1 | 1.85 € | 2.26 € | tme.eu | Unisolder (pin compatible to REF3030) | http://www.tme.eu/it/details/lm4120aim5-3.0_nop/fonti-di-tens-di-riferimento-circuiti/texas-instruments/lm4120aim5-30nopb/
U17 | MCP6V03-E/SN | 1.880000 € | 3 | 5.64 € | 6.88 € | tme.eu | Unisolder (same as MCP6V03-E/SN) | http://www.tme.eu/it/details/mcp6v03-e_sn/amplificatori-operazionali-smd/microchip-technology/
 | VIKING AR06BTCV1500 JBC sense 150ohm 0.1% | 0.137790 € | 10 | 1.38 € | 1.68 € | tme.eu | Unisolder
 | VIKING AR06BTCV5601 JBC sense 5,6kohm 0.1% | 0.137790 € | 10 | 1.38 € | 1.68 € | tme.eu | Unisolder
 | VIKING AR06BTCV0100 Calibration 10ohm 0.1% | 0.137790 € | 10 | 1.38 € | 1.68 € | tme.eu | Unisolder
 | INFINEON TECHNOLOGIES IPD031N03LGATMA1 | 0.693000 € | 2 | 1.39 € | 1.69 € | tme.eu | IPD053N08 equivalent
 |  |  |  | no VAT | with VAT
 | TOTAL |  |  | 281.67 € | 343.64 €
