valerionew/unisolder-notes/(list of files, cad)

Other CAD files:
original-resources/firmware/US_BootLoader.X/l.obj
original-resources/firmware/US_Firmware.X/l.obj
original-resources/sensor-board-firmware/US_sensor.X/dist/default/production/US_sensor.X.production.obj
original-resources/sensor-board-firmware/US_sensor.X/l.obj
