valerionew/unisolder-notes/(threads)

Thread 1 (2017-08-10):

Esp32 porting

Testato, 2017-08-10:
I propose to start to work on an Wiring porting for Esp32 mcu, with Ota+wifi+bt future expansion.

5N44P, 2017-08-10:
I don't know if the ESP can hanlde all the fpu computation (required for the pid), the original project uses a PIC32MX. Moreover there are no source file released at the moment, and the author doesn't plan to release them.
Btw this repo is just intended to be a bom and assembly guide, we should reefer to the original topic on Dangerousprototypes' forum...

PS we have still some work to do with [ADB-3020-CDV](https://github.com/Testato/ADB-3020-CDV)

Testato, 2017-08-10:
No open source project ?
Xxxxccccccbbnkllgfsshjk
Please add this info and link to the project on the first page of this Readme.

+1 for the ADB project

5N44P, 2017-08-10:
Schematics, gerbers and all the informations are released, but the board was designed in altium designer, expensive proprietary software... So anyway we couldn't do anything with the altium designer's files.

5N44P, 2017-08-10:
Also the firmware is open.
The only thing are the altium designer's files...

Testato, 2017-08-10:
Ok, so it is completely opensource and in teory is is possible a porting of the board files and firmware to for example eagle+wiring

Closed 2017-08-30.

Thread 6 (2018-11-23):

Q10, Q11 not in BOM?

nicola-d, 2018-11-23:
Hi,
I'm planning to assemble a unisolder unit and I found your notes very useful, especially the BOM.

I just have a small question: I did not find Q10 and Q11 listed in the Excel file but there is instead line 112 specifying two IPD031N03LGATMA1 as IPD053N08 equivalents.

But looking in the IPD031N03 datasheet, Vds(max) > 75v requirement is not met... Has this line to be corrected with another mosfet?

Thank you,
Nicola

5N44P, 2018-11-27:
I'll chech which part i've actually mounted on mine as soon as i have mine unisolder on hand. Thank you, that part caused me some trouble and some stop in the build for a while

nicola-d, 2018-11-27:
Intanto grazie mille per aver organizzato così bene le informazioni. Sono a pagina 63 del thread e mi rendo conto che sarebbe stato laborioso pescare info utili frammentate in vari post...

Grazie ancora!

5N44P, 2019-01-29:
I've checked and i can confirm that i'm currently using the IPD031N03 without problems

nicola-d, 2019-01-29:
Ok, thank you. Since I was already assembling the unit, I've opted for the FDD86367 to meet the requirements specified in the forum posts.

I can also tell you that I did not manage to program the PIC32MX with Arduino and pic32prog. It gave me a different target id each time and none of them was supported. With Pickit it worked at the first try.

xarenwo, 2019-05-25:
@nicola-d I live in Italy too, can you please let me know where you got all the components and how much was the approximate cost of building it ? Did you find the PCB or did you order from the gerbers ? Thanks

nicola-d, 2019-05-25:
I bought the PCB on Ebay and it was sent from Spain (11 euros shipped). Regarding the components, I mostly relied on the Excel spreadsheet on this repository (the TME + Farnell version). I had to find some equivalent parts though, because weren't available. I purchased the OLED display on Aliexpress. I already had the toroidal transformer. Approximately I spent 150 euros for a unit (but I have a lot of spare parts).

Thread 8 (2018-11-27):

Adding enclosures to the notes?

rsre, 2018-11-27:
Hi,

I was considering adding some talk about possible enclosures and how to build them. I don't know if there is much information regarding this topic in the thread. I've seen some aluminium extrusion enclosures, some 3D printed ones (like yours) and a few others.

What do you think?

5N44P, 2018-11-27:
I'd be happy to add them, but i've really no knowledge about what there is around. I know only mine and the modified one that Sparky is using.
If you want to add some lines about them, please do it, i'd be happy to add infos about my solution

nicola-d, 2018-11-27:
Hi,
this is just to say that I've ordered this (candidate) enclosure for the Unisolder:
https://it.farnell.com/hammond/1411ru/enclosure-utility-aluminium/dp/2763665

I will tell you if I'll manage to put all the stuff in there. Looks like that pcb at least will fit.

nicola-d, 2019-01-29:
I confirm there is enough room in the enclosure for all the stuff.

stclaus4, 2019-02-03:
https://www.hammfg.com/part/1411FBRU
or
https://www.hammfg.com/part/1402HV
should work

nicola-d, 2019-02-04:
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

My unisolder fits https://www.hammfg.com/part/1411RU perfectly (even if the transformer I'm using is a bit oversized).

I purchased the enclosure from Farnell (but it was actually shipped by Hammon directly).

CoolNamesAllTaken, 2019-04-21:
I found a nice looking case on thingiverse in case anyone had a 3d printer: https://www.thingiverse.com/thing:3460761

5N44P, 2019-04-21:
@CoolNamesAllTaken wow that looks amazing.
A while ago i started designing my own, i think i've linked [some photos](https://photos.app.goo.gl/i2XFoxWo3uCpuWpA9) in the thread.
But i like this one more than mine.

**Anyone volunteering to write the "Enclosure options" paragraph in the notes?**

Thread 13 (2020-01-26):

Programming Question

curieos, 2020-01-26:
Is the board supposed to have power when you're programming it? I have the PicKit3 plugged into the controller board and nothing else, and it's failing to program.

nicola-d, 2020-01-26:
Yes, the power provided by the programmer is not enough.

curieos, 2020-01-26:
Thank you for getting back to me so quickly!

Closed 2020-01-26.

Thread 14 (2020-01-30):

Wiring questions

curieos, 2020-01-30:
I figured out which pins were which on the power supply board, but now I need to figure out where they plug into the control board. I can't find anything about how to hook this up, pin 1 isn't labelled in any way.

nicola-d, 2020-01-30:
From http://dangerousprototypes.com/forum/index.php?topic=7218.msg66364#msg66364
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

curieos, 2020-02-04:
Thanks for showing me this!

Closed 2020-02-04.

Thread 15 (2020-02-07):

Board won't program

curieos, 2020-02-07:
I've tried multiple things, but the board won't program. I've powered it via the power supply board and everything. The programmer always errors out, saying it cant detect the appropriate voltage level. Any ideas on troubleshooting? I can upload pics of both boards tomorrow, but I'm pretty sure all the components are oriented correctly.

nicola-d, 2020-02-07:
I had some troubles as well when I first attempted to program the microcontroller. Now, I mostly forgot what the problem was... Just a few notes:

Remember to connect Pickit to UniS board, 'arrow' pin on Pickit should connect to programming pin UniS board - it is the only one with SQUARE pad, others are round pads. 5 pins on UniS board used out 6 pins on Pickit, pin 6 is not used.

Start MPLab IPE (not IDE app within the package, which is for development purposes).

You can find some more info on the forum: http://dangerousprototypes.com/forum/index.php?topic=7218.msg68299#msg68299

Hope this helps...

curieos, 2020-02-07:
I seem to have a short on my board somewhere on the 3.3v line. I'm not sure where though. I do know that I accidentally flipped the -.6v and 3.3v rails at one point, could I have possibly damaged something?

nicola-d, 2020-02-07:
U13 (MCP6V27-E/SN) is connected to the 3.3v and -0.6v rails (the others are connected to 3.3v and GND). Flipping those lines can have burned the chip and made an internal short circuit. Try to desolder U13 and check if the short is still present.

nicola-d, 2020-02-07:
Also U18 is powered by 3.3 and -0.6v.

curieos, 2020-02-07:
I tried both, one at a time, both seem fine unfortunately. I did find some extra solder under one of them that might've been shorting other things, so I've been checking all the others, but I haven't found the culprit yet.

nicola-d, 2020-02-07:
Also U16 is connected to -0.6v

nicola-d, 2020-02-07:
By the way, all these chips are not needed to program the PIC microcontroller.

curieos, 2020-02-07:
I figured. Unfortunately nothing I've tried has fixed things.

nicola-d, 2020-02-07:
You can locate the short(s) looking for points where the board heats up. For example touching the ICs still in place. But don't leave the board powered up for too long. If you have access to a thermal camera things are going to be a lot easier...

curieos, 2020-02-07:
I tried hooking the board up to an adjustable benchtop PSU set to 3.3v and 5 amps. It dropped down to .5v at 5 amps when I hooked it up, and I didn't feel anything getting warm. It's almost like the board itself is dead shorted?

nicola-d, 2020-02-07:
Well, 5 amps is way too much (I don't remember well but the front board draws something like 200mA). Are you sure there are no solder bridges somewhere? Examine thoroughly the each solder joint under a magnifying glass

curieos, 2020-02-07:
I've looked pretty extensively at the board for solder bridges. The only ones I've found were under U13 to C24 and under C62. To double check my sanity, I just pulled all of the non-passive components to make sure nothing was hiding underneath.

nicola-d, 2020-02-07:
Then, excluding a solder bridge, when the board is powered up you should sense a component become hot (and probably start to smoke) since is drawing 5 amps...

nicola-d, 2020-02-08:
If you wish, you can post some hi-res photos of the board. I'll try to help locating the troubles...

Tig3rch3n, 2020-02-08:
Hey ho,
I finished my Unisolder a few months ago and had some Flashing troubles as well but before I tried flashing I did some measurements first.

Some where on the forum someone posted a list of test points with the corresponding voltages.

Speaking about power consumption...
The PSU part without the Front bit pulled about 100-110mAh?

All connected without the Handle it used 170-185mAh

Like Nicola said, publish some High res Images...

And try the test points, first just the PSU and than connect everything and do some additional probing :p

curieos, 2020-02-08:
Here's a drive folder with images of my board.
https://drive.google.com/open?id=1Uwd7klpFu7USx8ZZ3M75HeDvMTSG1hE5

nicola-d, 2020-02-08:
Can you add another picture of U16 and surrounding area? That photo is a bit out of focus

curieos, 2020-02-08:
Done

nicola-d, 2020-02-08:
From the photos, it looks like two pins (bottom left and central) of U11 are bridged.

curieos, 2020-02-08:
Nice catch, no luck with the short though.

curieos, 2020-02-08:
Btw, just measured and it's a 0 ohm short

curieos, 2020-02-08:
I'm starting to think maybe one of the vias got some solder paste in it and maybe that's where the short is

nicola-d, 2020-02-08:
If you have a couple of sharp multimeter probes I would test each adjacent pin of U16 for continuity. The pitch is very small and it is easy to overlook a bridge.

nicola-d, 2020-02-08:
Also check C49 and C40. Not sure but there seems to be some bridging... They are connected to 3.3v and GND.

curieos, 2020-02-08:
Doesn't look like it, I was real careful with those two. They like to touch

curieos, 2020-02-09:
I found the short and got the board programmed. Turns out there was a short under C35

curieos, 2020-02-09:
New problem, LCD isn't working.

curieos, 2020-02-09:
Turns out I just flashed the incorrect bootloader/firmware. All is good! Thanks for all the help!

Closed 2020-02-09.

Thread 16 (2020-03-31):

Is there a firmware update plan?

chenpeng198877, 2020-03-31:

nicola-d, 2020-03-31:
I think the latest firmware can be found here:
http://dangerousprototypes.com/forum/index.php?topic=7218.msg70644#msg70644

nicola-d, 2020-03-31:
In any case, the original firmware source code is always available in the first post of the thread.

nicola-d, 2020-03-31:
And I think the original firmware is pretty much complete, as long as someone doesn't want to attach an unsupported iron/tip.

chenpeng198877, 2020-04-01:
> 我认为可以在这里找到最新的固件：[http](http://dangerousprototypes.com/forum/index.php?topic=7218.msg70644#msg70644) :
> [//dangerousprototypes.com/forum/index.php?topic=7218.msg70644#msg70644](http://dangerousprototypes.com/forum/index.php?topic=7218.msg70644#msg70644)

It's unknown for what reason! Nothing happens after the firmware is flashed! 1106 1306oled are all the same

valerionew, 2020-11-03:
Firmware is beeig now updated by the author in the new unisolder repo

Check it out at:
https://github.com/sparkybg/UniSolder-5.2

Closing as this is no longer relevant for this repo

Closed 2020-11-03.

Thread 18 (2020-08-04):

Problems with calibration

curieos, 2020-08-04:
I'd post this to the forum, but I'm not getting the verification emails when I sign up, and no one has responded.

I'm trying to calibrate my unisolder. When I go into the calibration menu, the R value is sitting at 35 with the 10 ohm resistor attached. I can turn the trimmer and have it go up to 40, or down and it goes to 30. If I disconnect the resistor, the value shoots up to 1100-ish. Reading the docs, it is supposed to be close to 1000 with the 10 ohm resistor? I tried searching through the forums, but I didn't find anything that solved my issue. I found some things that mentioned the current across Sense A and Vout1- should be around 380uA, mine measures 360uA (though I don't fully trust my multimeter). I double checked U11 was soldered on properly, as well as the PIC, but I haven't been able to figure it out. I even replaced Rc2 thinking it was a broken pot (original spun infinitely).

nicola-d, 2020-08-04:
I also had problems getting the verification email from the forum. After several tries I succeded though.

I don't remember much of the calibration procedure but I'm pretty sure it wasn't straightforward for me either. The values weren't the ones expected. I think I had to check and redo some solder joints to solve the problem...

curieos, 2020-08-05:
I figured the problem out, for some reason two of the pins on U17 were shorted somehow. I was able to calibrate, but now I have a new issue. When I plug the iron in it says "Heater Open". I double checked the wiring and I'm pretty sure the connector is wired up correctly. I'll do some more searching on the forum.

curieos, 2020-08-05:
When it said "Heater Open", the iron was correctly identified. I found a short on C17, resoldered it, and now it says "no instrument". I went into the calibration screen and the IDs are set to 5 and 5. I then found shorts on R2 and R21, fixed those, and the same issue is present. Not sure what is going on, I'll keep looking.

nicola-d, 2020-08-05:
Maybe this is of some help:

http://dangerousprototypes.com/forum/index.php?topic=7218.msg68141#msg68141

curieos, 2020-08-05:
The recommendation is to reprogram, but it looks like the problem was resolved by replacing the PIC... I'll do some more looking on the forum, maybe I'll find something where I don't have to replace the entire PIC and that will work...

curieos, 2020-08-05:
I figured it out, turns out I did wire it incorrectly. Had heater channel two + and - flipped. Guess that's what I get for soldering while tired. That explains why it detected the iron before, C17 was shorting channel 2 + and - together...

Closed 2020-08-05.

Thread 31 (2022-01-27):

How to make support other?

dgeorgiev92, 2022-01-27:
How to make support other accessories like desoldering iron on brand Weller like DSX 80 or JBC

rsre, 2022-01-31:
In the Dangerous Prototypes thread there's some information, for example: http://dangerousprototypes.com/forum/index.php?topic=7218.780

Thread 34 (2022-06-09):

New layout and updated BOM file

TurfControl, 2022-06-09:
Hello, I was in the market for an upgraded station at home and stumbled across this project.  I would like to do some design changes to make it easier to order mostly pick and placed.  I am not looking to take the design as my own or profit off of it, in fact I am more than willing to share all files 100% every step of the way.  I just finished the front board schematic into KI_CAD as it is my preferred software at work (only other option is PADS and I cant stand it anymore). if anyone would like to assist (and sparkybg approves) I would appreciate help finding new more available parts for the BOM.  if there are software designers out there interested in implementing any new features but require edits in the schematic i am happy to incorporate those edits.  I will be purchasing these from JLCPCB and just hand solder all the through hole components as required and will be more than happy to send off samples to anyone looking to add those software `integrations.

my first step is going to be just making replica schematics so if anyone wants to double check the connections.  then I will begin to edit the schematic to relevant and more available parts either splitting diodes/op amps or joining them for example.  I will be changing the regulator to newer IC something most likely with a higher switching frequency i prefer TI based IC's so I can use the webench designer for simplicity. please any input or requests i am excited about this project, and if nobody else chimes in I will at least be laying out my own board
Thank you
Ryan

valerionew, 2022-06-09:
Hey Ryan!
One thing that i always wanted to do is porting the project from pic32 to stm32, as they are more and more spread in the industry.
I think @sparkybg went for the pic32 as he had previous experience with it.

However, with stm32 getting more and more prominent in the industry, it may be easier to port the project to that platform. Personally i won't have time, but there are a lot of devs out

TurfControl, 2022-06-09:
That is something I can definitely implement.  Obviously I will need someone to work with on the project.  although I did take some programming classes in my past and I have written code for more than one micro (all 8 bit however), it is normally only for the proof of concept or testing my hardware. I can understand what many languages are doing but end up researching while writing it because I do not do enough of it.  With that being said I did forget to mention that I have a PM4 if there is anyone that wants to add hardware and write software for pic32 I can test and am willing to make more than 1 revision or dual footprint items, possibly make it more modular so that a daughter card can be used for testing hardware.

sparkybg, 2022-06-10:
@valerionew You are right - STM32 is spread in the **industry**. It is a mess for DIY - there's at least 10 to 20 IDEs, with equal number of C compilers, the documentation is complete mess, compared with Microchip one, and you have a bucket full of programmer/debugger options, vs PicKit3 that can program and debug every chip that microchip is produced.

IMHO, PIC32 may not be the best MCU, but is HUGELY more efficient and less problematic to program for a DIYer. Same counts for nearly every other Microchip's MCU so far - you have to install MPLAB and XC32 (from a same site), buy PicKit3, route 5 wires, and start programming your first MCU.

I've tried Atmel (AVR, Attiny, 8051) , Renesas (RX62n), and some STMs - so I thisn I know what I am talking about.

Yes, it is frustrating not to have any PI32MXs on the market. But there's PIC32MK for example. I don't know if they are PIN compatible, but they have everything I've desired - 50% higher freq, FPU, 12bit ADC.

...and, there's already some clones with different routing, of course with problems. We have gain of 750 and microamp current sources - you have to be VERY understanding why something is routed the way it is in my project - 1mA current here and there, and you have more than enough offset or ground loop in order to produce absolutely unacceptable offsets in the end result, blaming the software or iron profiles for inconsistencies.

TurfControl, 2022-06-10:
I completely understand there were difficulties and this board is definitely impressive.  I don't feel I am going to just throw something together all of the sudden and bam its better in every way....

but I feel removing some of the options that you have implemented such as place the resistors for iron selections hard to the board and if interest increases for a new revision of the board I could include a jumper header selector with all resistors on the board. (unless someone solves this in software)

swapping out the 2675 for something much more efficient and higher frequency followed with an LDO on the output which will allow for removal of a lot of input capacitance. likewise for all used voltages.  (possibly separating all power conversion to a power distribution style board)

I have only worked on the schematics at this point and haven't done any true analysis to determine expected current draw in different locations of circuit at different voltages which will be necessary before selecting the IC.  I just finished the schematics but need to double check them a few times before working on the BOM and making any changes. so deep dive into the GBR's i go

sparkybg, 2022-06-10:
1. Input capacitances are needed in order to have enough energy to save the options in the EEPROM when the controller is turned off. 2675 can work with much smaller capacitances already. :)

2. Higher frequency always means higher RFI to deal with.

3. 2675 is there mainly because of it's input voltage capability of 40V. most high frequency ones have far less max input voltage. This means linear regulator before them with much more disipation. The Darlington is already on the edge, so there must be a heatsink or something similar. And, the higher efficiency diminishes. :)

4. There is a simple (and cheap) negative supply circuit tied to it. Higher frequency devices in most cases means that this circuit must be made with separate switcher => more RFI and larger price.

When I designed this, I chose 2675 exactly because it was easy to obtain it from everywhere. There is no guarantee that the chip you use today will be available tomorrow.

Anyway, I am ready to discuss more detailed propositions.

The circuit needs +3.3V 1A (it appears that 0.5A is not enough with some displays), -0.6V 0.1A, with separate wiring/filtering for display and for the rest of the circuit. The circuit also needs around 6V high impedance supply for valley voltage, and 10-15V supply for MOSFET gate drive. Also, as I already mentioned, the supply needs to have large enough capacitance at it's input in order to provide at least 0.3 - 0.5 seconds of stable 3.3V supply to the MCU and the display after the power is switched off.

TurfControl, 2022-06-10:
That's all fantastic input thank you!

Higher frequencies always tend to have much more noise to go with them that will be a challenge I will have to deal with. I have had quite a bit of luck without even using LDO's on the output for proprietary wireless devices that I have in the field currently with the LMR16020 being a 60v input device capable of anywhere between 200k and 2.5Mhz switching allowing the use of a much smaller total footprint than the proven 2675. (i meant inductance earlier its the only drawback to the 2675)  This isn't a circuit I've even thought about yet as there are more than one voltage to consider as you mentioned. This IC is just one I'm familiar with in low noise required scenarios. Using these style devices can also require an extremely low esr capacitance meaning polymer caps which are on crazy shortage as well.

I haven't even begun making any schematic changes just double checking and developing a BOM while going over the GBR files.

sparkybg, 2022-06-10:
Unfortunately, LMR16020 is as unavailable as 2675 at the moment. Or at least I cannot find it stocked anywhere.

It is a good chip, no doubt about it. A bit harder to solder also, because of the power pad. This is also one of the reasons I am using 2675 - it is plain SOIC8 without power pads and so on. Very easy to work with.

However, 60V part will make the Darlington preregulator's job a lot easier. And, 60->3.3V will work with extremely low duty and eficiency.

As always, there's always a compromise that has to be done. :) And a good constructor is the one that knows how to make these. I am far from this - I tend to overprovision my circuits by a lot. :) But this either can be a good thing - as can be seen form the dangerous prototypes thread, overprovisioned DIY project can work even in an environment that it's constructor never considered. :) I had several "WTF" situations when I saw some implementations. And they work despite this. :)

i2, 2022-06-10:
I am very much interested in this. Unfortunately, I can't be of help on the electronics side but I will follow this project passionately!

TurfControl, 2022-06-10:
yeah the voltage drop from ~45-3.3v is quite intense off the bridge.

I see a lot of stock on the IC on JLC or LCSC 7500 and the 3 amp part is expected this month for delivery of close to another 16k available.  using the IC would be similar to just the ability of a 2675hv just smaller inductor in value and size.

Another option i was considering was only stepping to a lower more efficient voltage with a 1 amp model then stepping down with LDO's for the necessary voltage requirements. in order to sustain 1A at 3.3V it would be difficult without external heatsinks so removing circuitry ends up adding other things meaning no space or BOM saving. But when i get around to deeper circuit analysis this is one area i was considering looking deeper into.

without a chip shortage it would be as simple as just grabbing a LMR36520 I haven't been able to get my hands on those since they were released and that has 70v transient safety with greater than 80% efficiency on a voltage variance of 45 input - output.

the compromise you are referencing is exactly why im open with my intentions. There is no part of this i would say i am an expert in.  I am happy with my talents but humble enough to admit there are many people smarter than i here.  hopefully with the people that followed this in the past or continue to build upon it but didn't want to invest the time of hardware design work will do so through me.

valerionew, 2022-06-10:
Sorry to jump in without a thorough read of the past comments, I've only read them quickly. But i think there is an important point that i want to make:

If changes to the BOM have to be made, I think that the right direction is the one towards ease of sourcing. A more generic part with more pin-to-pin replacement for me will always be better than a better performing part with an unique package sold by only one seller. And this i think is particularly true for a DIY projects with such big number of parts.

So i think one of the objectives of the redesign could be this, together with reducing the part numbers count. I don't have the schematic in front of me right now, but i think there were some parts that can be swapped for others already in the BOM.

What do you guys think?

TurfControl, 2022-06-10:
Yes i completely agree with you on that one.  the regulator i was talking about earlier is actually quite popular but I don't know of any pin/pin compatible replacements from aftermarket sources where as the 2576 has been copied by everyone under the sun.  furthermore package changes can be made just from the last few years advancements in technology making things cheaper and just as available.

if there are hardware revisions at all that anyone is interested in helping with before the board goes into proto phase i am happy to hear it.

as I mentioned earlier the only thing I'm doing right now is creating the BOM with packages that are available specifically looking for ones available in china for pick and place use.  then I will do an initial layout

sparkybg, 2022-06-11:
> i think one of the objectives of the redesign could be this, together with reducing the part numbers count. I don't have the schematic in front of me right now, but i think there were some parts that can be swapped for others already in the BOM.

You should be more specific on this. I can't remember of parts that cen be removed. In fact the last 5-6 revisions of the board was pretty much the opposite - you make the pcb, assemble it, and ten there's a problem and some parts need to be added to resolve it., or chematics/leyoutr need to be altered in some way.

valerionew, 2022-06-11:
> You should be more specific on this. I can't remember of parts that cen be removed.

You're right! I promise that I'll check what my memory is vaguely remembering and get back to you! As soon as I finish my exam session (hopefully)

Thread 35 (2022-07-25):

Q10, Q11 missing from TME Farnell BOM

valerionew, 2022-07-25:
No trace of Q10, Q11 on https://github.com/valerionew/unisolder-notes/blob/master/BOMs/Unisolder%20BOM%20TME%20Farnell.xlsx

This is serious.

valerionew, 2022-07-25:
Well, actually they are in the bom, last row, just not labelled Q10 and Q11. Not good but not that tragic

Thread 37 (2023-10-29):

Rotary Encoder information

wildstar87, 2023-10-29:
Was having a lot of problems getting a rotary encoder to work.  Finally found this note, buried in the thread.  Would be nice to put this into your notes so it's more easily found.

Information was found here in the main thread:
http://dangerousprototypes.com/forum/index.php?topic=7218.msg71747#msg71747

The control method is selected this way:
- go to menu
- press and hold center button ot encoder button for 5 seconds
- pres and release center button to select the control option
- leave it alone for 5 seconds and it will exit

The meaning of options:
- KEYS - the plain old 3 button control
- ENC-A-1PPD - encoder with channel A event, 1 pulse per detent
- ENC-AB-2PPD - encoder with channel A and channel B event, 2 pulses per detent (one for A and one for B)
- ENC-A-2PPD - encoder with channel A event, 2 pulses per detent
- ENC-AB-4PPD - encoder with channel A and channel B event, 4 pulses per detent (2 for A and 2 for B channel)

Just select what works best for you. The goal is to select an variant which leads to change of temperature/option with one up or one down per detent.

There is a connection picture here: http://dangerousprototypes.com/forum/index.php?topic=7218.msg74587#msg74587
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

valerionew, 2023-10-30:
Thank you. I really think that would be useful, I didn't even know you could use a rotary encoder. Are you comfortable preparing a PR for adding that?

wildstar87, 2023-10-30:
Not sure what a PR is in this case.
________________________________
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

valerionew, 2023-10-31:
Pull request - modifying the file in the repository and submitting the modification to be inlcuded in the main page.

If you cannot do this, we can see if anyone wants to contribute

wildstar87, 2023-11-30:
I made the PR, but never done it before, so let me know if I screwed something up.

valerionew, 2023-11-30:
Fixed by #38

Closed 2023-11-30.
