valerionew/unisolder-notes/(commit log)

2017-06-02 Added connectors, U1, U6, U14, Q2
2017-06-04 Added sleep sensor, U10, U15
2017-07-06 Added Resistor ID table
2017-07-07 Added programming and capacitors
2017-07-11 Corrections, added some diodes
2018-10-21 added TME+farnell BOM
    [bom_unisolder.xlsx]
2018-11-08 added refs
    [bom_unisolder.xlsx]
2019-03-11 initial commit, incomplete
    [bom_unisolder.xlsx]
2019-03-18 add chips and bom
    [bom_unisolder.xlsx]
2019-03-25 add pictures
    [bom_unisolder.xlsx]
2019-03-25 add original BOM for reference
    [UniSolder52_BOM_original_25Mar2019_Download.xls]
2019-03-28 add more pictures from https://www.eevblog.com/forum/projects/universal-soldering-controller-5-2-kit-and-general-construction-questions!/
2019-03-30 rearange, upadte BOM
    [UniSolder52_BOM_original_25Mar2019_Download.xls, Unisolder BOM Digikey.xlsx, bom_unisolder.xlsx]
2019-04-01 correct PN for 3.3V regulator
    [Unisolder BOM Digikey.xlsx]
2019-04-22 Moved BOMs to a dedicated folder
    [UniSolder52_BOM_original_25Mar2019_Download.xls, Unisolder BOM Digikey.xlsx]
2019-04-22 renamed schematics folder
2019-04-22 added my bom that was previously removed in the fork
    [Unisolder BOM TME Farnell.xlsx]
2020-01-27 Added link to the interacrive pcb map
2020-03-29 Create original-gerbers
2020-03-29 Reorganized original files mirrored here
    [US_sensor.X.production.obj, l.obj, resID.xlsx]
2020-11-02 added original author's repository as submodule, removed deprecated copy
    [US_sensor.X.production.obj, l.obj, resID.xlsx]
2020-11-02 Weller WMRT, PACE TD100 Black, JBC C105/C115 resistor IDs added, opamp substitutions added
    * Update README.md
    Weller WMRT, PACE TD100 Black, JBC C105/C115 resistor IDs added, opamp substitutions added
    * readme edit
    sss
    * Revert "readme edit"
    This reverts commit b6a142036c82c1376b373de682641ce45a8d4dba.
    * Update README.md
2020-11-03 Set up submodule to track main branch
2020-11-16 Display detection, cold junction sensor reading
2023-11-30 Update README.md
    Added Rotary Encoder information, and made U19 replacement section a little more clear.
