valerionew/unisolder-notes/(notices)

Notices in the files:
README.md:
License CC-BY-4.0
